isadora-fernanda/coffeteira-arduino/(commit log)

2026-10-14 Adiciona projeto Coffeteira de Sistemas Embarcados (2022)
    Cafeteira programável com Arduino Mega 2560, desenvolvida em equipe na disciplina de Sistemas Embarcados (UTFPR, 2022). Inclui firmware, esquemático, projeto da PCB no EasyEDA, arquivos Gerber, foto do protótipo e fluxograma.
2026-10-15 Remove nomes da equipe, corrige comentários e refaz o fluxograma
    [Coffeteira.ino]
2026-10-15 Volta a foto do protótipo para o tamanho original
2026-10-15 Adiciona revisão da placa ao que eu faria diferente
